iorodeo/rodeostat_featherwing/README.md

# IO Rodeo Potentiostat Feather Wing

Hardware design for IO Rodeo's Rodeostat Featherwing.

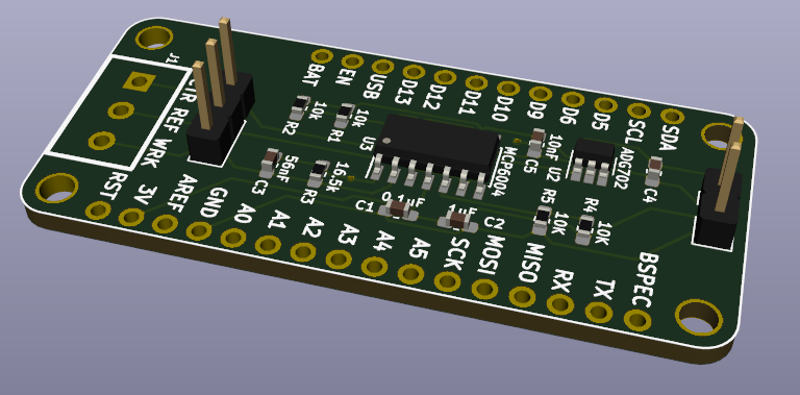
[picture p1: images/screenshot_3d.png]


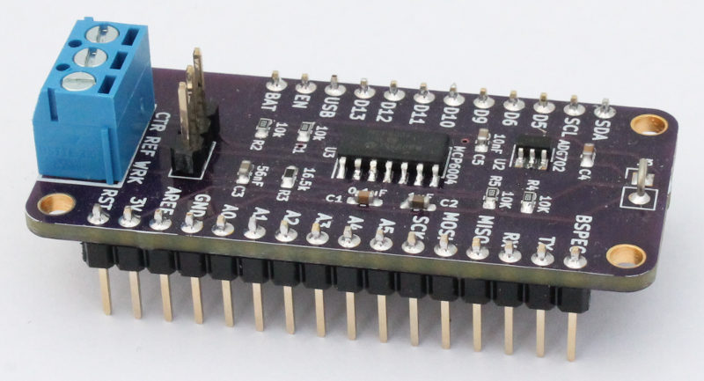
[picture p2: images/prototype_1.png]


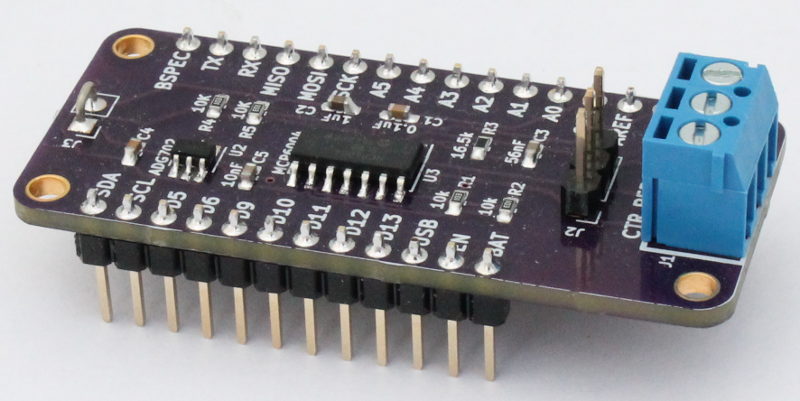
[picture p3: images/prototype_2.png]


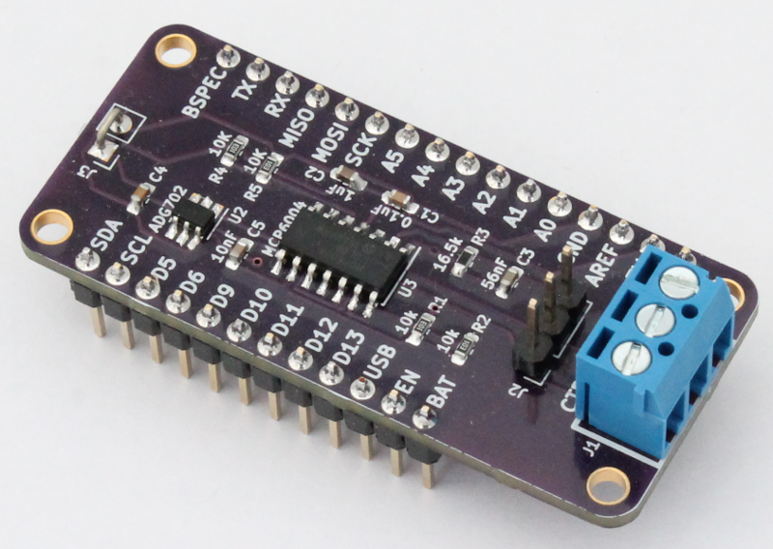
[picture p4: images/prototype_3.png]
