iorodeo/rodeostat_featherwing/images/potentiostat_featherwing_3d.png

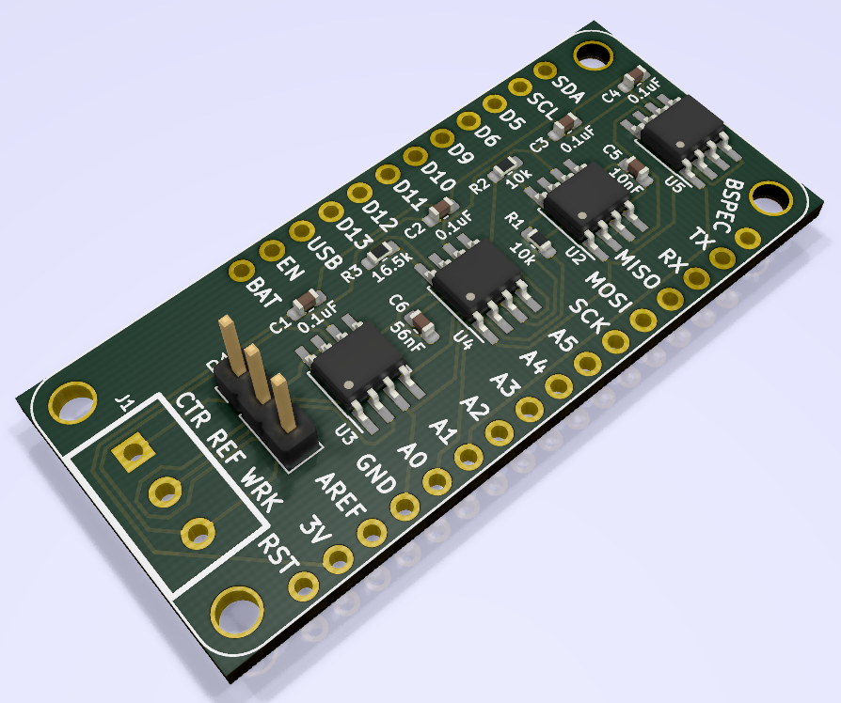
images/potentiostat_featherwing_3d.png
