iorodeo/rodeostat_featherwing/v0p3/gerber_v0p3_r1/1000_uA/BOM_JLCPCB_1000uA_alt1.xlsx

Comment | Designator | Footprint | LCSC Part #（optional） | Qty
0.1uF ceramic capacitor | C1, C4 | 603 | C14663 | 2
1.0uF ceramic capacitor | C2 | 603 | C15849 | 1
68nF ceramic capacitor | C3 | 603 | C31658 | 1
10nF ceramic capacitor | C5 | 603 | C57112 | 1
10k resistor | R1, R2, R4, R5 | 603 | C309083 | 4
1.65k resistor | R3 | 603 | C103334 | 1
TS5A3160 SPDT Analog Switch | U2 | SOT-23-6L | C185770 | 1
Quad op amp MCP6004 | U3 | SOIC-14_3.9x8.7x1.27P | C116668 | 1
