iorodeo/rodeostat_featherwing/v0p3/potentiostat_featherwing.pdf

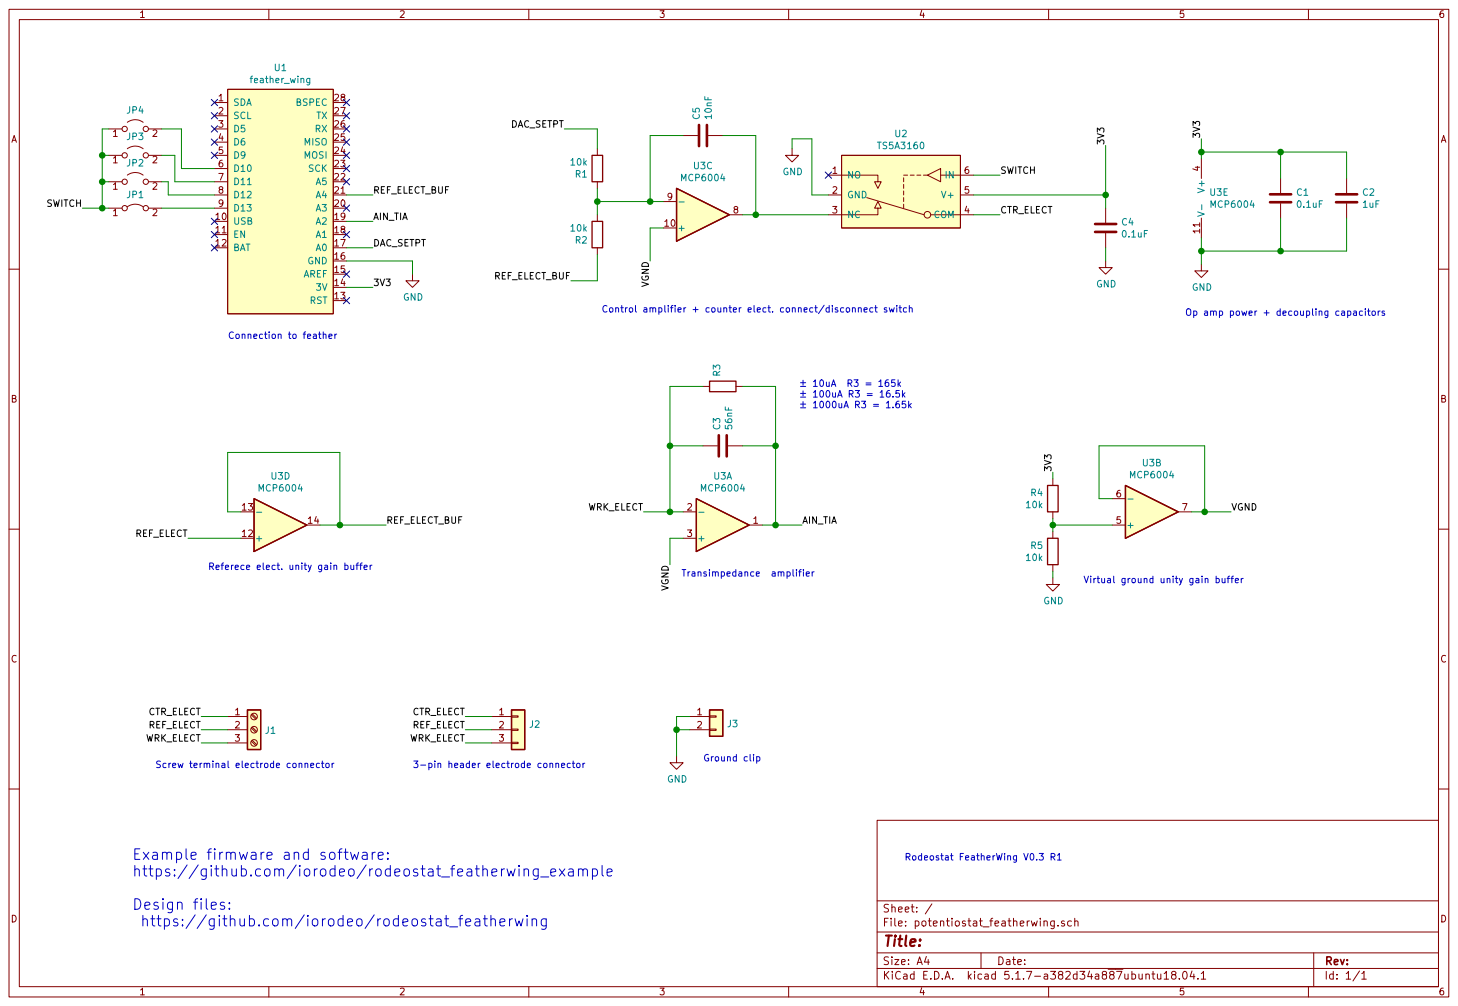
[picture p6: page 1]

± 10uA R3 = 165k ± 100uA R3 = 16.5k ± 1000uA R3 = 1.65k 3-pin header electrode connector

https://github.com/iorodeo/rodeostat_featherwing_example

Design files:
https://github.com/iorodeo/rodeostat_featherwing
