iorodeo/rodeostat_featherwing/v0p1/potentiostat_featherwing.pdf

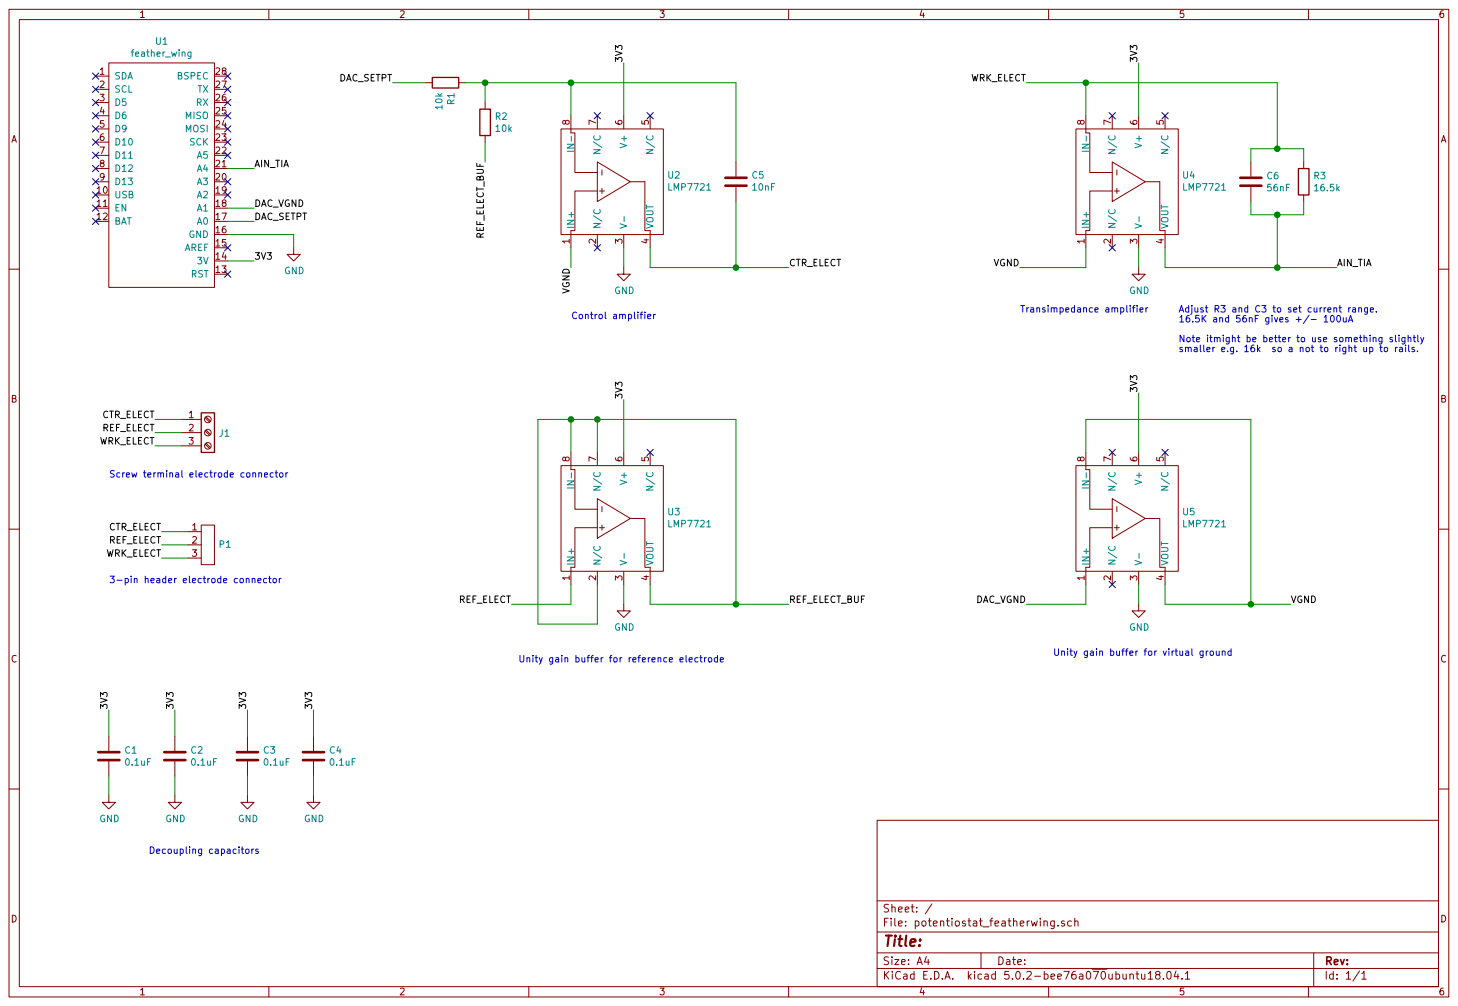
[picture p7: page 1]

Adjust R3 and C3 to set current range.
16.5K and 56nF gives +/- 100uA
Note itmight be better to use something slightly
smaller e.g. 16k so a not to right up to rails.

Unity gain buffer for virtual ground C1
0.1uF GND3V3

Unity gain buffer for reference electrode
