iorodeo/rodeostat_featherwing/(list of files, drawings)

Other design files:
v0p1/potentiostat_featherwing.dsn
v0p3/potentiostat_featherwing.dsn
