iorodeo/rodeostat_featherwing/v0p3/potentiostat_featherwing.kicad_pcb

## KiCad design v0p3/potentiostat_featherwing.kicad_pcb (2021-10-03)

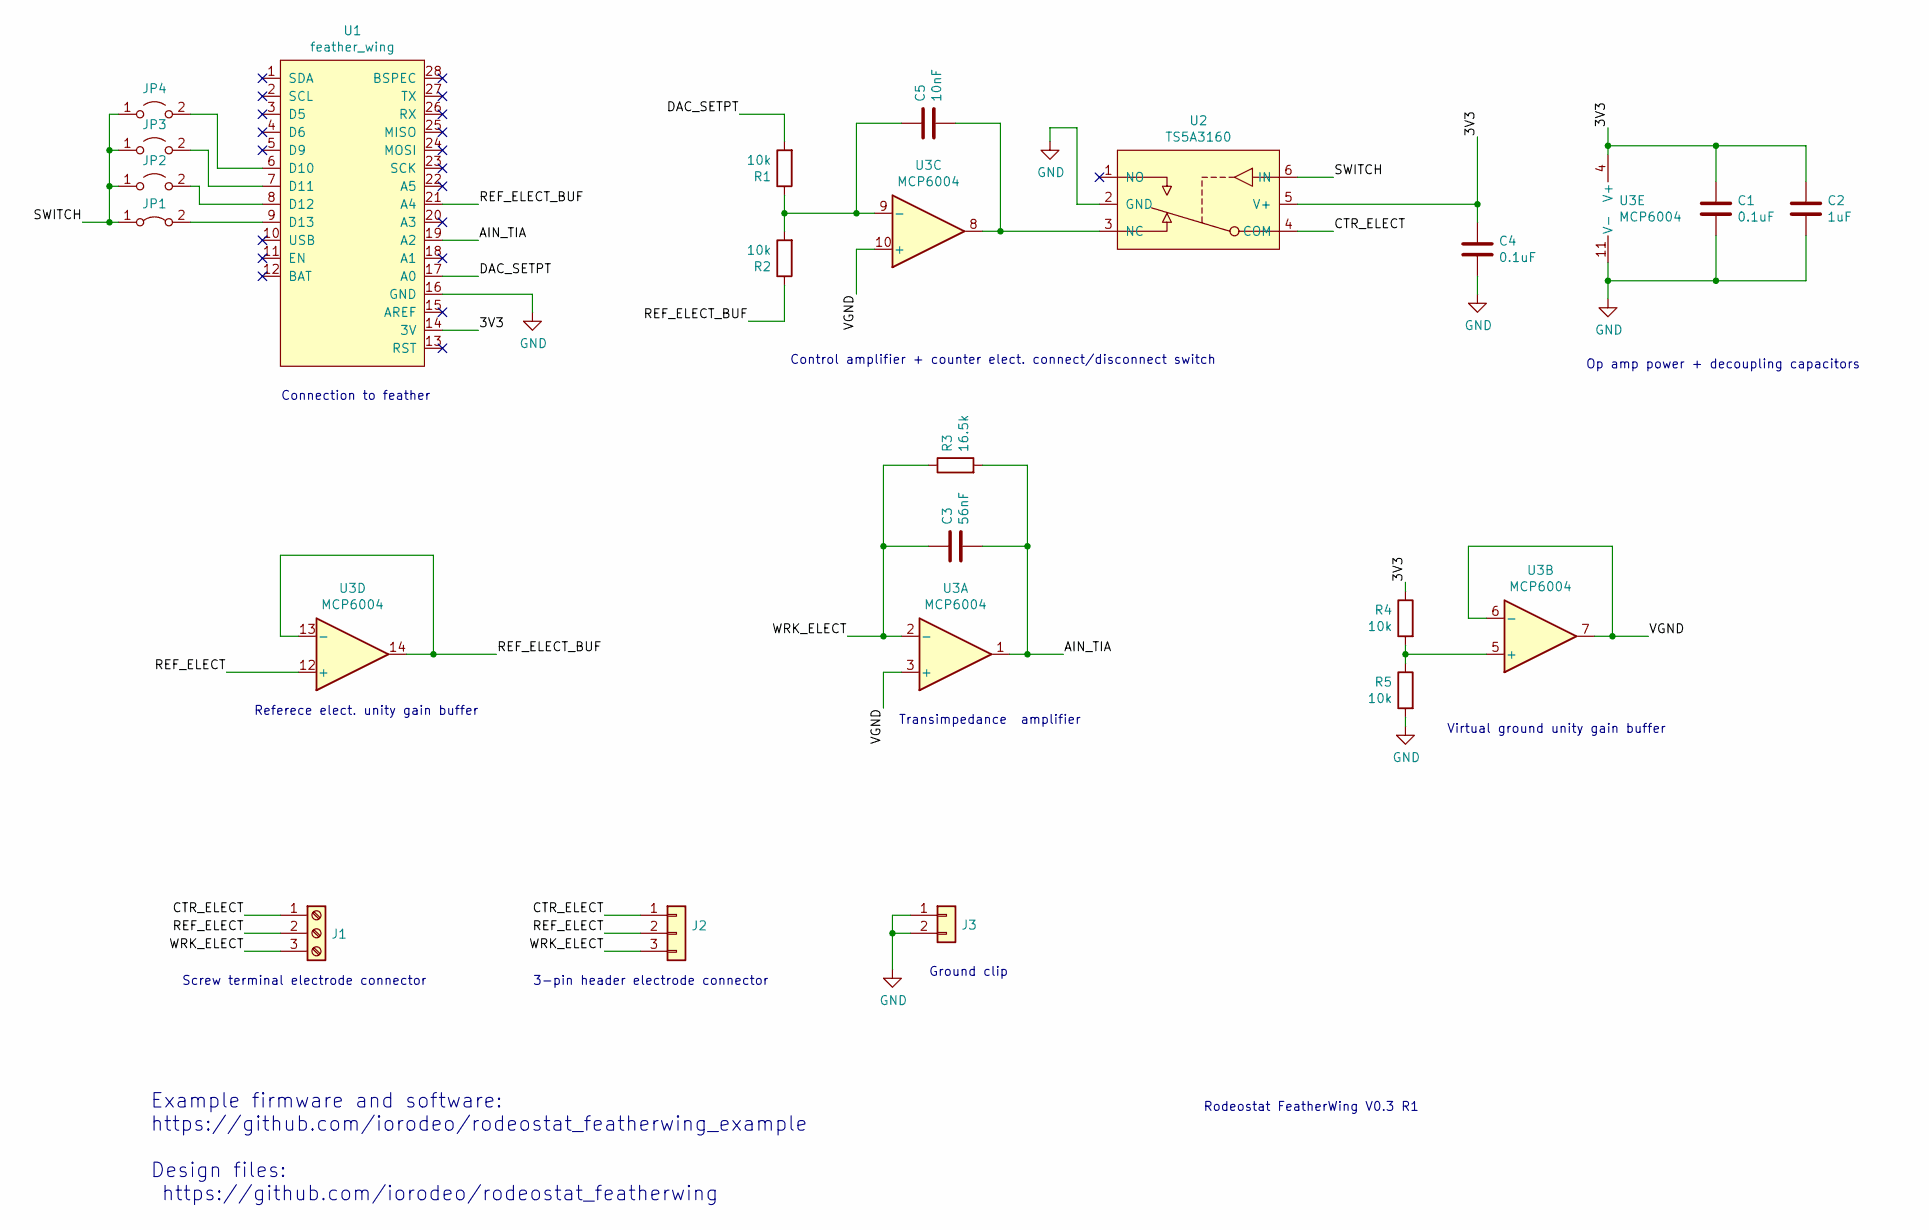
[picture p8: schematic potentiostat_featherwing.sch]

Parts:
C1, C4: 0.1uF; C_0603_1608Metric
C2: 1uF; C_0603_1608Metric
C3: 56nF; C_0603_1608Metric
C5: 10nF; C_0603_1608Metric
J1: Screw_Terminal_01x03; CONNBLOCK3
J2: Conn_01x03; PinHeader_1x03_P2.54mm_Vertical
J3: Conn_01x02; PinHeader_1x02_P2.54mm_Vertical
JP1: Jumper_2_Bridged; SolderJumper-2_P1.3mm_Bridged_Pad1.0x1.5mm
JP2, JP3, JP4: Jumper_2_Open; SolderJumper-2_P1.3mm_Open_TrianglePad1.0x1.5mm
R1, R2, R4, R5: 10k; R_0603_1608Metric
R3: 16.5k; R_0603_1608Metric_Pad0.98x0.95mm_HandSolder
U1: feather_wing
U2: TS5A3160; SOT-23-6
U3: MCP6004; SOIC-14_3.9x8.7mm_P1.27mm

Connections:
/3V3: C1.1, C2.1, C4.1, R4.1, U1.14 (3V), U2.5 (V+), U3.4 (V+)
/AIN_TIA: C3.2, R3.2, U1.19 (A2), U3.1
/CTR_ELECT: J1.1, J2.1, U2.4 (COM)
/DAC_SETPT: R1.2, U1.17 (A0)
/REF_ELECT: J1.2, J2.2, U3.12 (+)
/REF_ELECT_BUF: R2.1, U1.21 (A4), U3.13 (-), U3.14
/SWITCH: JP1.1 (A), JP2.1 (A), JP3.1 (A), JP4.1 (A), U2.6 (IN)
/VGND: U3.3 (+), U3.6 (-), U3.7, U3.10 (+)
/WRK_ELECT: C3.1, J1.3, J2.3, R3.1, U3.2 (-)
GND: C1.2, C2.2, C4.2, J3.1, J3.2, R5.2, U1.16 (GND), U2.2 (GND), U3.11 (V-)
unnamed: C5.1, U2.3 (NC), U3.8
unnamed: C5.2, R1.1, R2.2, U3.9 (-)
unnamed: JP1.2 (B), U1.9 (D13)
unnamed: JP2.2 (B), U1.8 (D12)
unnamed: JP3.2 (B), U1.7 (D11)
unnamed: JP4.2 (B), U1.6 (D10)
unnamed: R4.2, R5.1, U3.5 (+)

Notes on the sheet:
Screw terminal electrode connector
3-pin header electrode connector
Referece elect. unity gain buffer
Connection to feather
Control amplifier + counter elect. connect/disconnect switch
Op amp power + decoupling capacitors
Virtual ground unity gain buffer
Transimpedance amplifier
Ground clip
Rodeostat FeatherWing V0.3 R1
Example firmware and software: https://github.com/iorodeo/rodeostat_featherwing_example Design files: https://github.com/iorodeo/rodeostat_featherwing

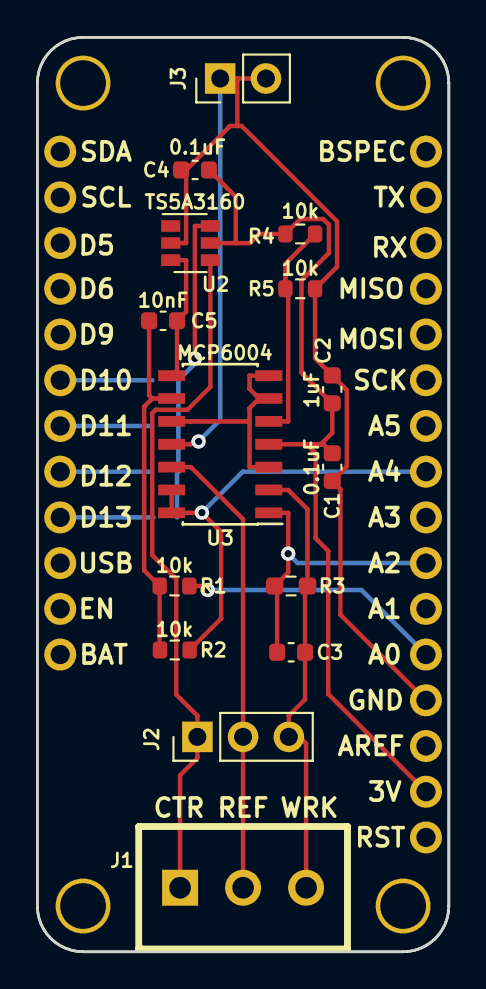
[picture p9: board v0p3/potentiostat_featherwing.kicad_pcb from above]

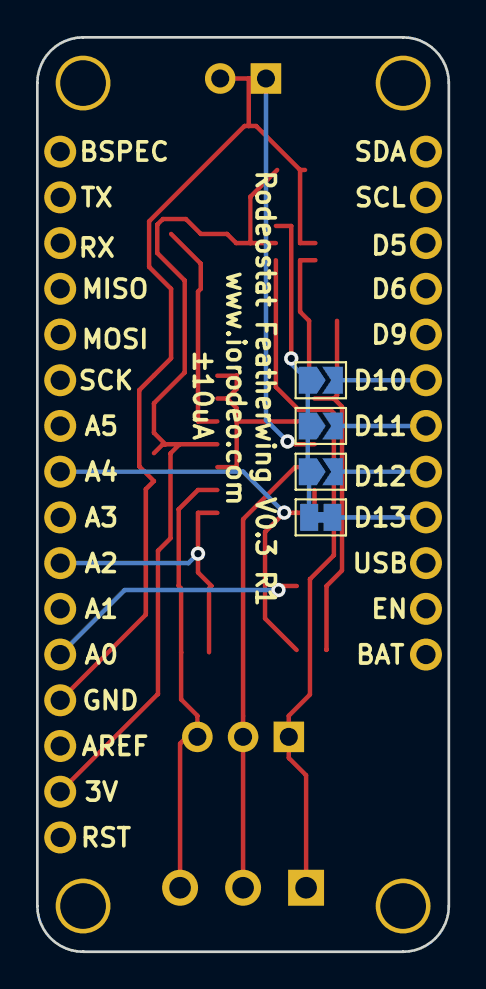
[picture p10: board v0p3/potentiostat_featherwing.kicad_pcb from below]

Board: 2 copper layers, 22.9 x 50.8 mm, 20 parts (4 on the bottom side), 17 nets.
