iorodeo/rodeostat_featherwing/v0p1/potentiostat_featherwing.kicad_pcb

## KiCad design v0p1/potentiostat_featherwing.kicad_pcb (2020-02-03, an earlier design)

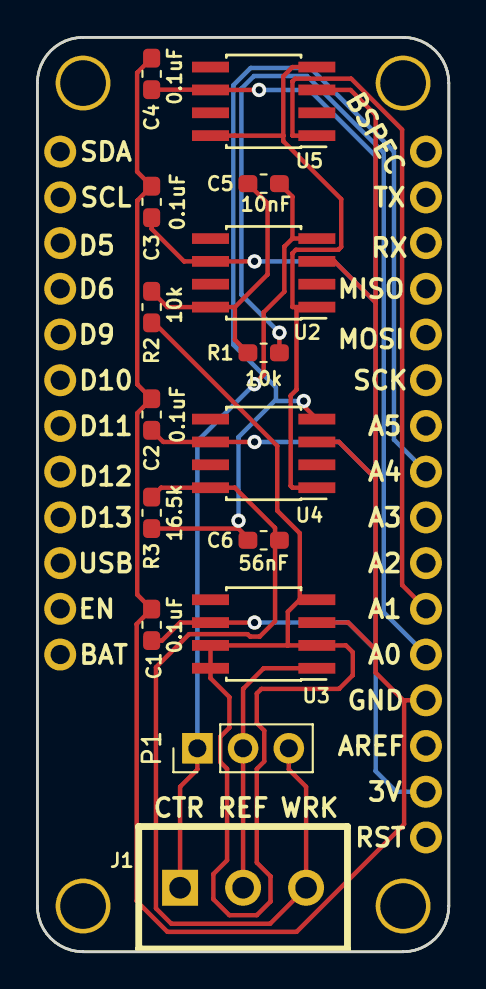
[picture p11: board v0p1/potentiostat_featherwing.kicad_pcb from above]

Board: 2 copper layers, 22.9 x 50.8 mm, 16 parts (0 on the bottom side), 11 nets.

Parts:
C1, C2, C3, C4: 0.1uF; C_0603_1608Metric_Pad1.05x0.95mm_HandSolder
C5: 10nF; C_0603_1608Metric_Pad1.05x0.95mm_HandSolder
C6: 56nF; C_0603_1608Metric_Pad1.05x0.95mm_HandSolder
J1: Screw_Terminal_01x03; CONNBLOCK3
P1: pin_array_3x1; PinHeader_1x03_P2.54mm_Vertical
R1, R2: 10k; R_0603_1608Metric_Pad1.05x0.95mm_HandSolder
R3: 16.5k; R_0603_1608Metric_Pad1.05x0.95mm_HandSolder
U1: feather_wing
U2, U3, U4, U5: LMP7721; SOIC-8_3.9x4.9mm_P1.27mm_HandSolder

Connections:
/3V3: C1.1, C2.1, C3.1, C4.1, U1.14, U2.6, U3.6, U4.6, U5.6
/AIN_TIA: C6.2, R3.2, U1.21, U4.4
/CTR_ELECT: C5.1, J1.1, P1.1, U2.4
/DAC_SETPT: R1.2, U1.17
/DAC_VGND: U1.18, U5.1
/REF_ELECT: J1.2, P1.2, U3.1
/REF_ELECT_BUF: R2.2, U3.2, U3.4, U3.7, U3.8
/VGND: U2.1, U4.1, U5.4, U5.8
/WRK_ELECT: C6.1, J1.3, P1.3, R3.1, U4.8
GND: C1.2, C2.2, C3.2, C4.2, U1.16, U2.3, U3.3, U4.3, U5.3
unnamed: C5.2, R1.1, R2.1, U2.8
