iorodeo/rodeostat_featherwing/(commit log)

2019-08-22 Project creation.
    [potentiostat_featherwing.dsn, potentiostat_featherwing.kicad_pcb, potentiostat_featherwing.sch]
2019-09-12 Modified design so that ref elect (buffered) can be measured by analog input.
    [potentiostat_featherwing-B.Cu.gbr, potentiostat_featherwing-B.Mask.gbr, potentiostat_featherwing-B.Paste.gbr, potentiostat_featherwing-B.SilkS.gbr, potentiostat_featherwing-Edge.Cuts.gbr, potentiostat_featherwing-F.Cu.gbr, potentiostat_featherwing-F.Mask.gbr, potentiostat_featherwing-F.Paste.gbr]
2020-02-03 Added new v0.2 version of the featherwing design.
    [potentiostat_featherwing-B.Cu.gbr, potentiostat_featherwing-B.Mask.gbr, potentiostat_featherwing-B.Paste.gbr, potentiostat_featherwing-B.SilkS.gbr, potentiostat_featherwing-Edge.Cuts.gbr, potentiostat_featherwing-F.Cu.gbr, potentiostat_featherwing-F.Mask.gbr, potentiostat_featherwing-F.Paste.gbr]
2020-02-06 Created version 0.2 of the design. Changed op amps. Added switch. Added ground test point.
    [potentiostat_featherwing-B.Cu.gbr, potentiostat_featherwing-B.Mask.gbr, potentiostat_featherwing-B.Paste.gbr, potentiostat_featherwing-B.SilkS.gbr, potentiostat_featherwing-Edge.Cuts.gbr, potentiostat_featherwing-F.Cu.gbr, potentiostat_featherwing-F.Mask.gbr, potentiostat_featherwing-F.Paste.gbr]
2020-02-13 Fixed issue with v0p2 BOM.
2020-06-14 Minor modifications for schematic - no substantive changes. Remade gerber files for v0p2_r2.
    [potentiostat_featherwing-B.Cu.gbr, potentiostat_featherwing-B.Mask.gbr, potentiostat_featherwing-B.SilkS.gbr, potentiostat_featherwing-Edge.Cuts.gbr, potentiostat_featherwing-F.Cu.gbr, potentiostat_featherwing-F.Mask.gbr, potentiostat_featherwing-F.SilkS.gbr, potentiostat_featherwing-NPTH.drl]
2020-12-13 Added v0p3 of design. Modified for turnkey assembly.
    [BOM_JLCPCB.xlsx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]
2020-12-13 Fixed component orientations is CPL file.
    [BOM_JLCPCB.xlsx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]
2021-01-12 Remade pdf of schematic.
    [potentiostat_featherwing.sch]
2021-01-12 Remade pdf of schematic add links to repositories.
    [potentiostat_featherwing.sch]
2021-10-03 Added gerbers, BOM and CPL for the four different ranges.
    [BOM_JLCPCB.xlsx, BOM_JLCPCB_1000uA.xlsx, BOM_JLCPCB_100uA.xlsx, BOM_JLCPCB_10uA.xlsx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]
2021-10-29 Modified schematics so resistor values for different current ranges are shown.
    [potentiostat_featherwing.sch]
2023-01-27 Added alternative BOM for 100uA design.
    [BOM_JLCPCB_100uA_alt1.xlsx]
2023-05-29 Added alternate BOM for rodeostat featherwing.
    [BOM_JLCPCB_1000uA_alt1.xlsx, BOM_JLCPCB_10uA_alt1.xlsx]
